christoph-weiser/mpw7/(threads)

Thread 1 (2022-11-14):

Layout of IP blocks

Ahmedredamohamed2022, 2022-11-14:
Hello,
I hope my message finds you well.
I am writing to you if you can please provide us with the layout of each IP block (*.mag), individually.
such as:
Bandgap reference.
linear regulators, 1.2V and 1.5V.
Clock generator.
Bias current/voltage generator.
10-bit SAR-ADC
Test buffer with multiplexer input.
"https://github.com/christoph-weiser/mpw7"

I am waiting for your kind reply
thanks
Ahmed Reda

christoph-weiser, 2022-11-14:
You'll find a file called design.gds.gz ([design.gds.gz](https://github.com/christoph-weiser/mpw7/blob/7d5b22818e6880276f84ce850211723f0d270da0/gds/design.gds.gz)) in the gds folder of this repository.

 That file is hierachical, so if you open it in klayout you can simply right click on the block of interest and "Save Selected Cells As" to save any of the blocks as individual gds or mag files.

Ahmedredamohamed2022, 2022-11-14:
Can i read  your gds file using MAGIC, please?

christoph-weiser, 2022-11-14:
Yes just decompress the design.gds.gz and open it with magic. You can also use the cell manager in magic to load the cells of interest and then save the cell as a new gds or mag file.

```
gunzip design.gds.gz
magic design.gds
```

Ahmedredamohamed2022, 2022-11-16:
Thank you .  Excuse me I have one more question.  did you have a documentation for each designed IP block including simulation results? can you share it with me please?

christoph-weiser, 2022-11-16:
I have thus far not created any detailed result documentation. You will however find all the required testbenches to evaluate the performance of each block for yourself.

Closed 2022-11-20.

Thread 2 (2022-11-20):

Bandgap cell

Ahmedredamohamed2022, 2022-11-20:
Hello,
I hope my message finds you well.
I am writing to you because i got an error when simulating the bandgap as shown.
Here, I want to describe what i did
1-I generated bandgap_lvs.spice  from bandgap.gds
2- I used bandgap_tb_tc.spice with bandgap_lvs.spice
3- I opened a terminal and wrote ngspice bandgap_tb_tc.spice and found the shown error.
can you help me to fix this error.
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
bandgap_lvs.spice , bandgap.gds, and bandgap_tb_tc.spice  are attached in the next link
 `https://github.com/Ahmedredamohamed2022/Manual_Lab`

christoph-weiser, 2022-11-20:
You missed to include the subckt definition of the pnp device.
I think the required file from the pdk is found in models/all.spice

Ahmedredamohamed2022, 2022-11-20:
I would like to inform you that, i simulated the schematic circuit successfully. However, when I generated the bandgap_lvs.spice from the layout and re-simulate the testbench again , i found this error.
Is there any other file should i add to simulate the bandgap_lvs.spice !

christoph-weiser, 2022-11-21:
Ok. In that case I think I know what is going on. The tool will extract a circuit that is different than the one in the PDK. . So check what pins the pnp device has in the PDK. Then check how the device is extracted with magic. There is even a tutorial on [youtube](https://www.youtube.com/watch?v=U4ox29-Oauw) on this topic. I also made a script to fix this problem you find it in my [ic_tools](https://github.com/christoph-weiser/ic_tools) repo.

Ahmedredamohamed2022, 2022-11-22:
yeah, I got it. Thank you for your patience
Here, I simulated the extracted  spice from the layout and adjust the pnp terminals.  However, I get a difference between the pre-layout and post layout simulation. Does it mean  the extracted spice file is not correct.
Extracted spice file is attached here <https://github.com/Ahmedredamohamed2022/Manual_Lab>
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

Ahmedredamohamed2022, 2022-11-23:
Hi, I found why the simulation result of extracted spice is not matched with the post-layout simulation result.  When doing LVS
 check , the  Netlists do not match, as shown. Do you think there is a wire in the layout is not connected as a schematic, right!
 or i do not have the last version of the layout.
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

Ahmedredamohamed2022, 2022-11-23:
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

Ahmedredamohamed2022, 2022-11-23:
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

Ahmedredamohamed2022, 2022-11-23:
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

Ahmedredamohamed2022, 2022-11-23:
both gates have the same label/port!  is it right!!

christoph-weiser, 2022-11-23:
Yes you are right. You can open the layout one level up in the hierachy to see, which pin is which, since the naming is correct there. I don't see the issue, because remove labels of subblocks before I run lvs.

Ahmedredamohamed2022, 2022-11-23:
Thanks. Excuse me what does it mean this error!
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

christoph-weiser, 2022-11-26:
The first picture tells you that in Circuit 1 two sky130_fd_pr__pnp_05v5 devices have a connection from vss to the second node of the subckt. In Circuit 2: here are also two connections from vss to the second node of the subckt. However there are also additional two connections from vss to the first node of the subckt.

The second picture then tells you that there are connetions found in one netlist that cannot be found in the other. It also states that this is regarding the first port of sky130_fd_pr__pnp_05v5. It assigns this net a automatic name called a_26_26.

These lvs errors can be difficult to debug, but it looks like you have shorted port 1 and port 2 in the circuit 2, which is not the case in circuit 1.

Ahmedredamohamed2022, 2022-11-26:
yeah, I got it. Thank you for your guidance.

Closed 2022-11-27.

Thread 3 (2022-11-28):

Analog and Digital LDO

Ahmedredamohamed2022, 2022-11-28:
Hi, I am writing to ask what is the different between the analog and digital LDO!
I think both LDOs have the same structure, right!
but, how I can get 1.2 V and 1.5 V from both!

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

christoph-weiser, 2022-11-28:
Hi, yes they are indeed identical. The difference is the reference voltage applied to the LDO. The output voltage of the LDO is 2x the reference voltage applied to the vref pin.

Ahmedredamohamed2022, 2022-11-29:
Thank you for kind reply. I a have one more question, please.  i want to know what is the maximum load current of LDO?
do you have the electrical characterization parameters of the LDO which includes load/line regulation, max/min load current, efficiency, dropout voltage, ...?

Closed 2022-12-01.

Thread 4 (2022-12-17):

LDO and Bandgap at Vdd of 3.3V!

Ahmedredamohamed2022, 2022-12-17:
Hello, I am writing to double-check if the design of the LDO and bandgap circuits can operate at a Vdd of 3.3V.
By the way, the simulation testbench did not complain when i simulate the LDO and bandgap circuits with Vdd of 3.3V
Is it OK? can I rely on the simulation results, for now?
what do you think?
Thanks

christoph-weiser, 2022-12-18:
No i would not suggest that. The devices used in the circuit are nfet_01v8 and pfet_01v8, which means that you should not use them with 3.3V. But perhaps you can modify the circuit to operate with the nfet_03v3, pfet_03v3 devices.

Closed 2022-12-28.
