christoph-weiser/mpw7/(commit log)

2022-07-22 added content
    [ac_bias_amp.sch, ac_regulator.sch, ac_se_folded_ota_np_ab.sch, ac_se_folded_ota_p.sch, ac_trim.sch, bandgap.sch, bandgap_amp.sch, bg_res.sch]
2022-09-06 added additional design ressources
    [capacitor.step]
2022-09-10 xschem updates
    [xschem_top.sch]
2022-11-19 filled out user_defines.v pin setup definitions
2022-11-24 adressed label issue in the bg circuit
