christoph-weiser/mpw7/(notices)

Notices in the files:
docs/source/index.rst:
.. |License| image:: https://img.shields.io/badge/License-Apache%202.0-blue.svg
